iOsnaaente/Seguidor_analogico/Images/Placa cnc.jpeg

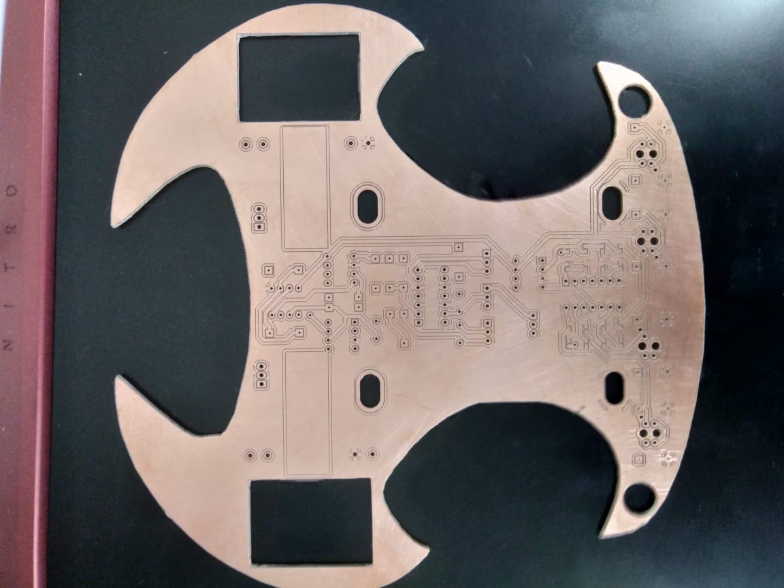
Images/Placa cnc.jpeg
