iOsnaaente/Seguidor_analogico/README.md

# Seguidor_analogico
Projeto de criação de um seguidor de linha analógico utilizando os conceitos de Amplificadores Operacionais e lógica de controle de sistemas.
Projeto realizado para prova de conceito e participação de campeonato de seguidor de linha analógico em Charqueadas RS 2022.
