iOsnaaente/Seguidor_analogico/Images/Bottom.PNG

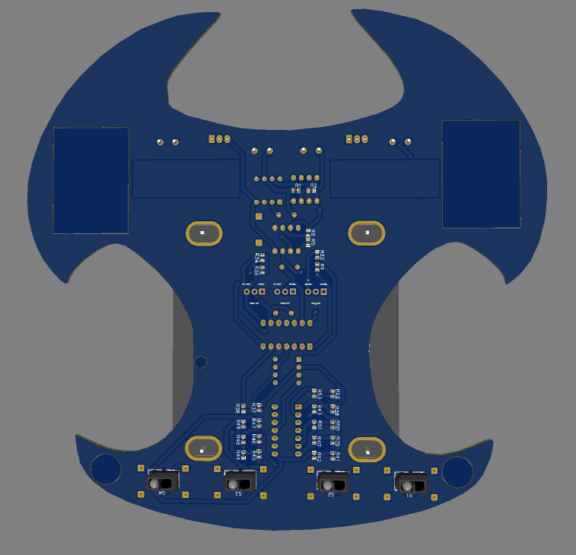
Images/Bottom.PNG
