iOsnaaente/Seguidor_analogico/Images/Top.PNG

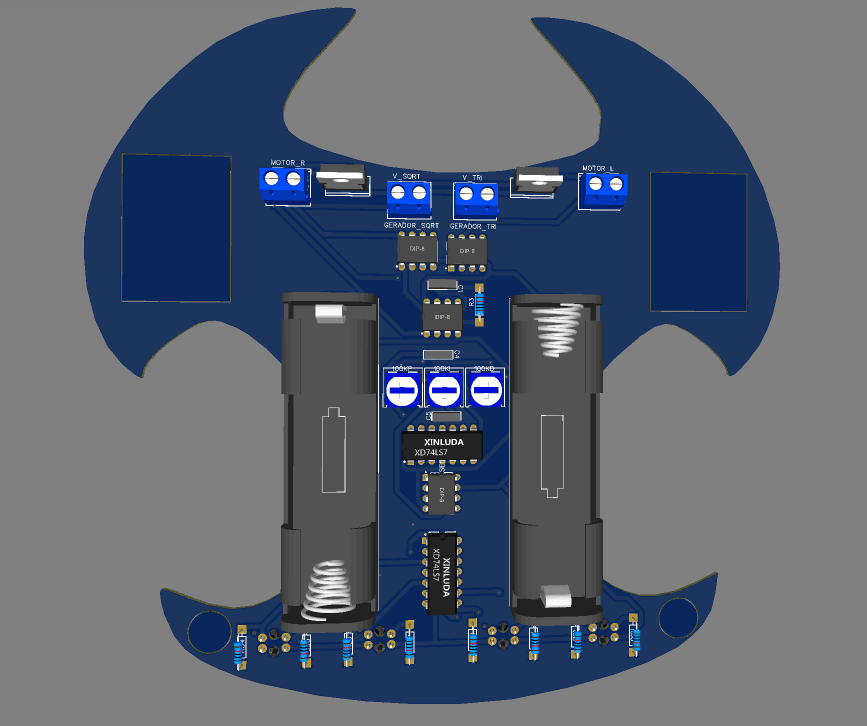
Images/Top.PNG
