iOsnaaente/Seguidor_analogico/LTSpice/Seguidor_de_linha_analogico.asc

C1: cap; 10n
C2: cap; 100n
C3: cap; 100n
C4: cap; 10n
M1: nmos
M2: nmos
Motor_L: res; 1
Motor_R: res; 1
R1: res; 10k
R2: res; 10k
R3: res; 470k
R4: res; 10k
R5: res; 20k
R6: res; 10k
R7: res; 10k
R8: res; 10k
R9: res; 10k
R10: res; 10k
R11: res; 10k
R12: res; 10k
R13: res; 10k
R14: res; 10k
R15: res; 22k
R16: res; 22k
R17: res; 10k
R18: res; 10k
R19: res; 10k
R20: res; 10k
R21: res; 10k
R22: res; 10k
R23: res; 10k
R24: res; 10k
R25: res; 10k
R26: res; 10k
R27: res; 10k
R28: res; 10k
R29: res; 10k
R30: res; 10k
R31: res; 150
R32: res; 47k
U1: LM741
U2: LM741
U3: LM741
U4: LM741
U5: LM741
U6: LM741
U7: LM741
U8: LM741
U9: LM741
U10: LM741
U11: LM741
U12: LM741
U13: LM741
U14: PC817D
V1: voltage; 1
V2: voltage; 0
V3: voltage; 3.7
V4: voltage; 3.7
V5: voltage; 3.7
Vbat+: voltage; 3.7
Vbat-: voltage; 3.7
Named nets: 0, V+, Triangular, V-, PWM-, PWM+, Sinal_sensores, Sinal_PID
.tran 0 50m 45m
Inversor
Não inversor
Posso otimiar usando o peso da soma diferente para os multiplicadores
E usar somente ampop nos inversores
Fonte
Oscilador
Integrador - Triangular
Sensores
Pode fazer sinal invertido com NOT
Somador
Gerador da onda triangular
Somador
Proporcional
Derivativo
Integrativo
Controlador PID
Comparador
Inversor
Saída para atuação
Atuadores
Motor Esquerda
Motor Direita
Pode usar um CI NOT
