iOsnaaente/Seguidor_analogico/LTSpice/Oscilador/Oscilador_astavel.asc

Bat1: voltage; 3.7
Bat2: voltage; 3.7
C1: cap; 10n
R1: res; 100k
R2: res; 10k
R3: res; 10k
U1: ADTL082
U2: LM741
Named nets: V+, 0, V-, Vtri, Vsqrt
.tran 0 2 1
320Hz com 2.4V de pico
