iOsnaaente/Seguidor_analogico/LTSpice/Sensores/Sensores.asc

Bat1: voltage; 3.7
Bat2: voltage; 3.7
R1: res; 10k
R2: res; 10k
R3: res; 20k
R4: res; 10k
R10: res; 10k
R11: res; 10k
R14: res; 20k
R15: res; 10k
R18: res; 10k
R19: res; 20k
R20: res; 20k
R21: res; 10k
R22: res; 10k
U1: ADTL082
U2: ADTL082
U3: ADTL082
U4: ADTL082
U8: LM741
VS1: voltage; 1.7
VS2: voltage; 1.7
VS3: voltage; 1.7
VS4: voltage; 1.7
Named nets: V+, 0, V-, Vo
.tran 0 0.2 0.1
Inversor
Não inversor
Somador
