iOsnaaente/Seguidor_analogico/(list of files, drawings)

Other design files:
Proteus/Seguidor_linha.pdsprj
